Balage/Tea-Timer-with-Arduino/media/tea_timer_1.jpg

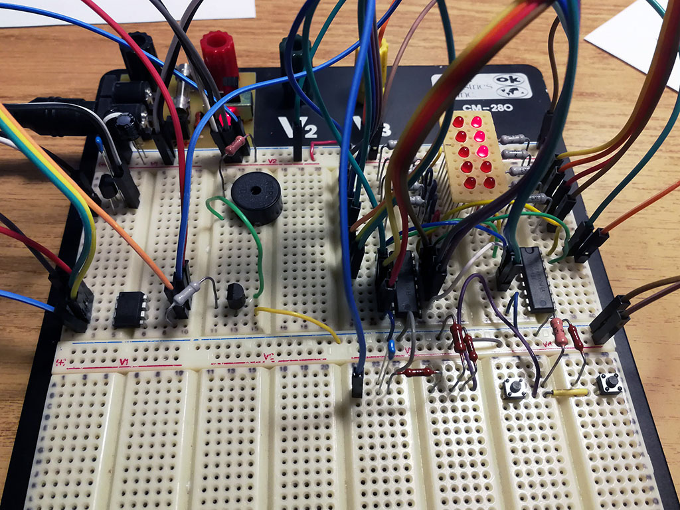
media/tea_timer_1.jpg
