Balage/Tea-Timer-with-Arduino/media/tea_timer_2.jpg

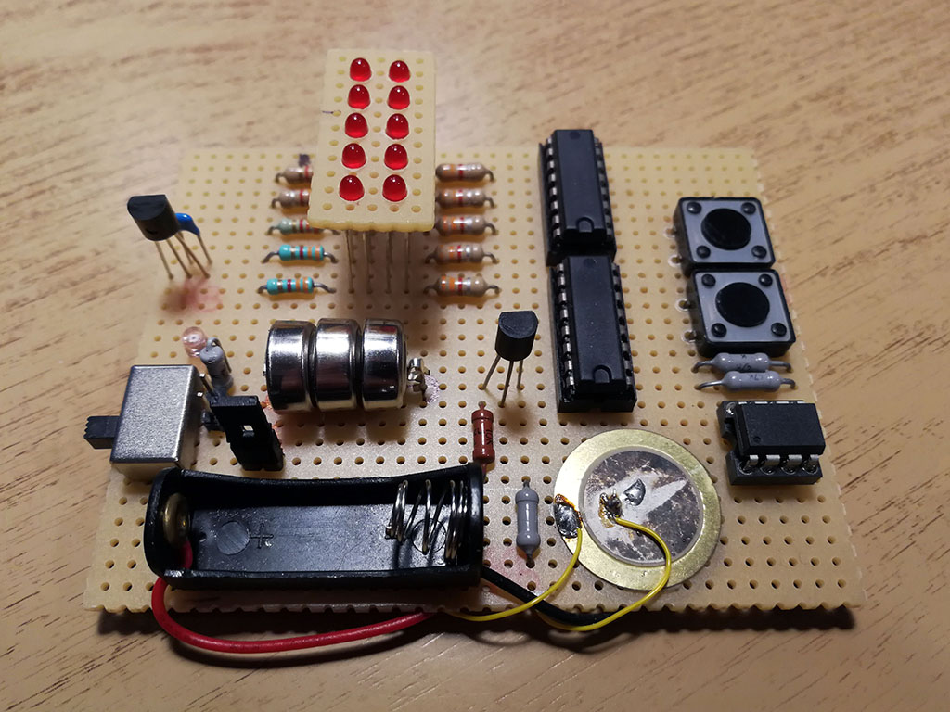
media/tea_timer_2.jpg
