Balage/Tea-Timer-with-Arduino/media/tea_timer_3.jpg

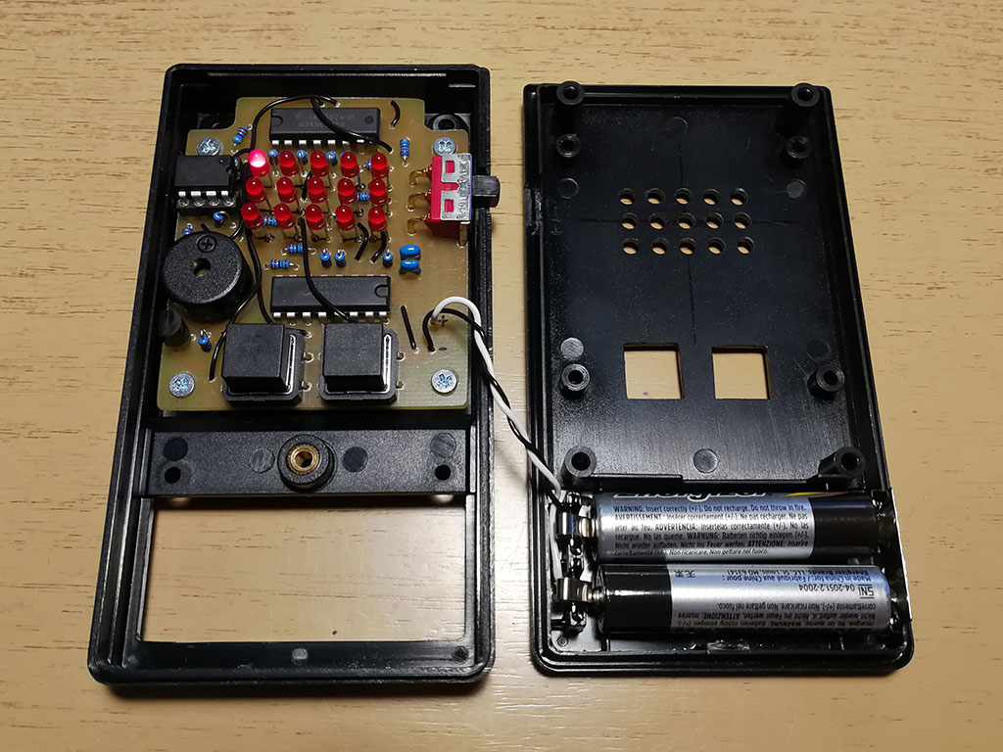
media/tea_timer_3.jpg
