Balage/Tea-Timer-with-Arduino/media/tea_timer_4.jpg

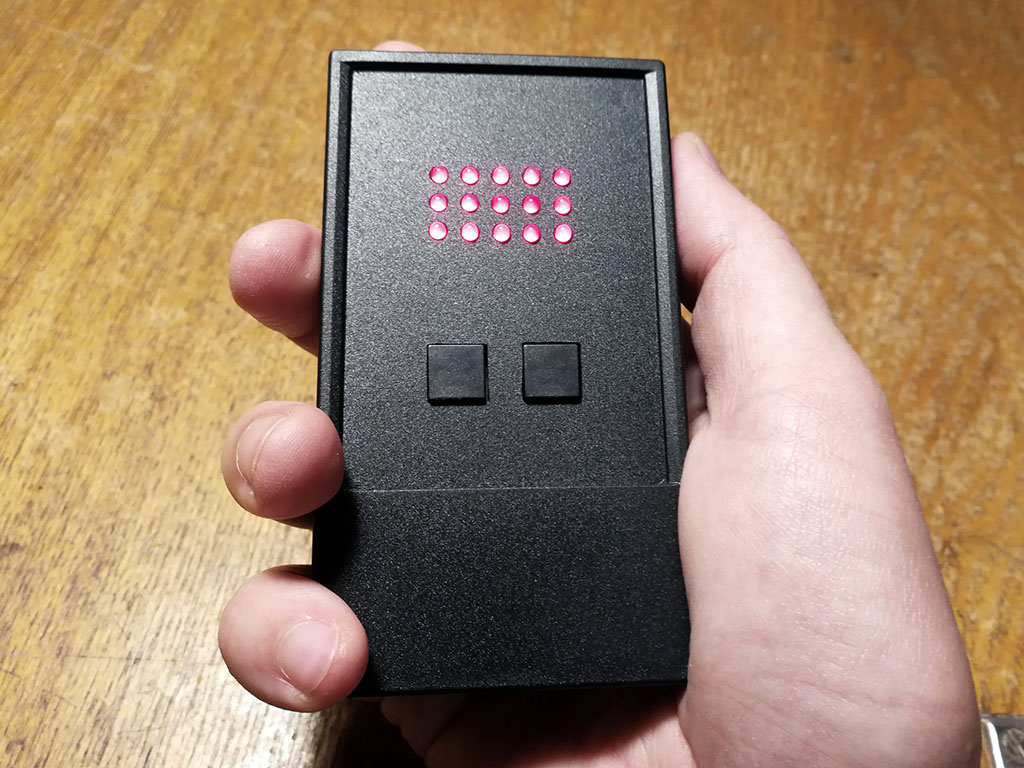
media/tea_timer_4.jpg
