Balage/Tea-Timer-with-Arduino/media/tea_timer_5.jpg

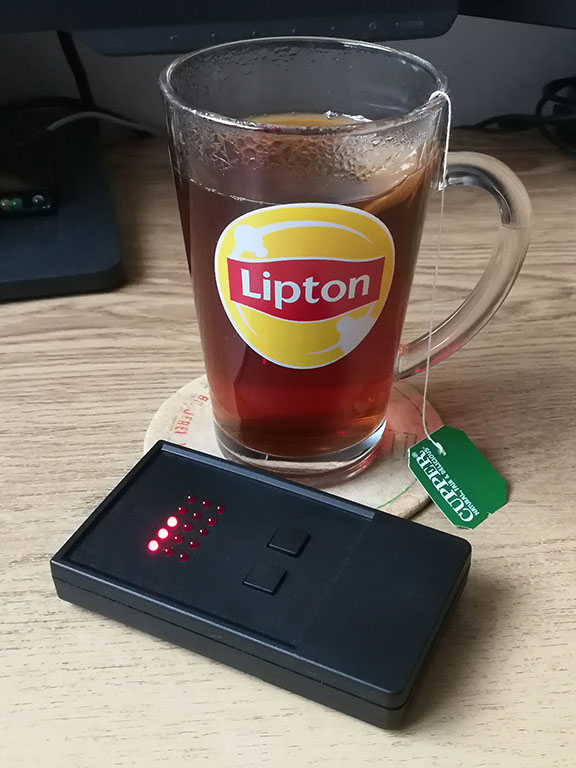
media/tea_timer_5.jpg
